adafruit/Adafruit-bq25185-with-5V-Boost-PCB/Adafruit bq25185 with 5V Boost Breakout.brd

## EAGLE design Adafruit bq25185 with 5V Boost Breakout.brd (2024-12-04)

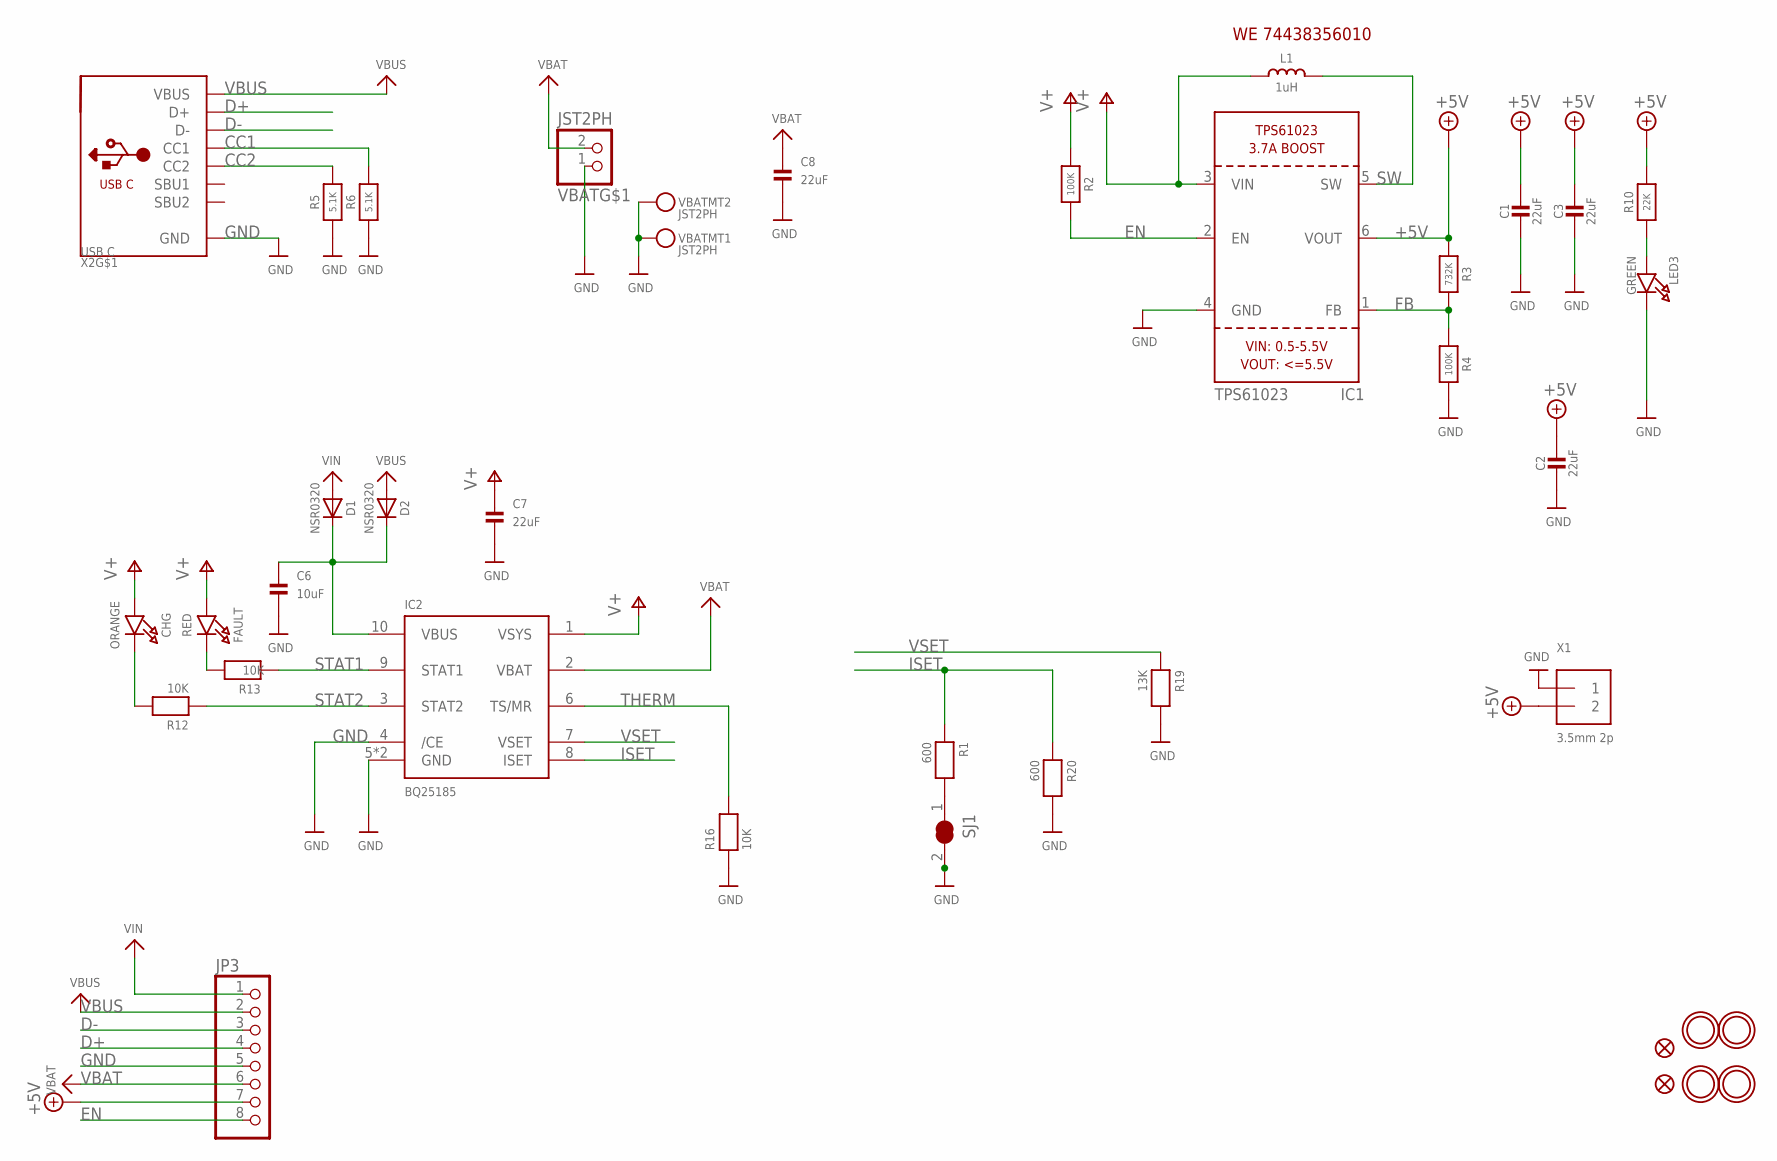
[picture p2: schematic Adafruit bq25185 with 5V Boost Breakout.sch, sheet 1]

Parts:
C1, C2, C3, C7, C8: 22uF; 0805-NO
C6: 10uF; 0805-NO
CHG: ORANGE; CHIPLED_0603_NOOUTLINE
D1, D2: NSR0320; SOD-323_MINI
FAULT: RED; CHIPLED_0603_NOOUTLINE
FID1, FID2: FIDUCIAL_0.5MM
IC1: TPS61023; SOT563
IC2: BQ25185; WSON10
JP3: HEADER-1X870MIL; 1X08_ROUND_70
L1: 1uH; INDUCTOR_5045_SMALLTABS
LED3: GREEN; CHIPLED_0603_NOOUTLINE
R1, R20: 600; _0402NO
R2, R4: 100K; _0402NO
R3: 732K; _0402NO
R5, R6: 5.1K; _0402NO
R10: 22K; _0402NO
R12, R13, R16: 10K; _0402NO
R19: 13K; _0402NO
SJ1: SOLDERJUMPER_CLOSED; SOLDERJUMPER_CLOSEDWIRE
U$9, U$10, U$11, U$12: MOUNTINGHOLE2.5; MOUNTINGHOLE_2.5_PLATED
VBAT: JST2PH; JSTPH2_BATT
X1: 3.5mm 2p; TERMBLOCK_1X2-3.5MM
X2: USB C; USB_C_CUSB31-CFM2AX-01-X

Connections:
+5V: C1.1, C2.1, C3.1, IC1.6 (VOUT), JP3.7, R3.1, R10.2, X1.2
CC1: R6.2, X2.A5 (CC1)
CC2: R5.2, X2.B5 (CC2)
D+: JP3.4, X2.A6 (D+), X2.B6 (D+)
D-: JP3.3, X2.A7 (D-), X2.B7 (D-)
EN: IC1.2 (EN), JP3.8, R2.2
FB: IC1.1 (FB), R3.2, R4.1
GND: C1.2, C2.2, C3.2, C6.2, C7.2, C8.2, IC1.4 (GND), IC2.4 (/CE), IC2.5 (GND), IC2.PAD (GND), JP3.5, LED3.C, R4.2, R5.1, R6.1, R16.1, R19.2, R20.2, SJ1.2, VBAT.1, VBAT.NC1, VBAT.NC2, X1.1, X2.A1B12 (GND), X2.B1A12 (GND)
ISET: IC2.8 (ISET), R1.1, R20.1
unnamed: R1.2, SJ1.1
unnamed: C6.1, D1.C, D2.C, IC2.10 (VBUS)
unnamed: CHG.C, R12.2
unnamed: LED3.A, R10.1
unnamed: FAULT.C, R13.2
STAT1: IC2.9 (STAT1), R13.1
STAT2: IC2.3 (STAT2), R12.1
SW: IC1.5 (SW), L1.2
THERM: IC2.6 (TS/MR), R16.2
V+: C7.1, CHG.A, FAULT.A, IC1.3 (VIN), IC2.1 (VSYS), L1.1, R2.1
VBAT: C8.1, IC2.2 (VBAT), JP3.6, VBAT.2
VBUS: D2.A, JP3.2, X2.A4B9 (VBUS), X2.B4A9 (VBUS)
VIN: D1.A, JP3.1
VSET: IC2.7 (VSET), R19.1

Notes on the sheet:
WE 74438356010

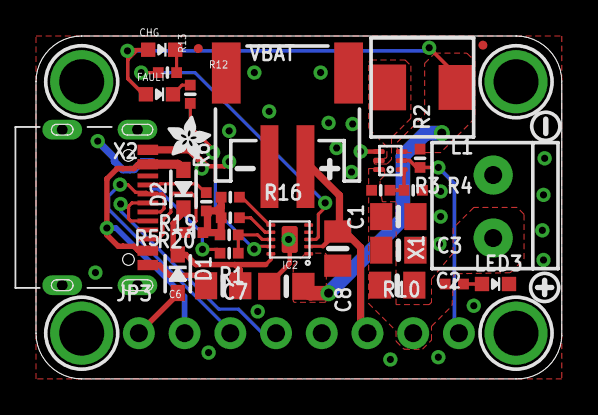
[picture p3: board Adafruit bq25185 with 5V Boost Breakout.brd from above]

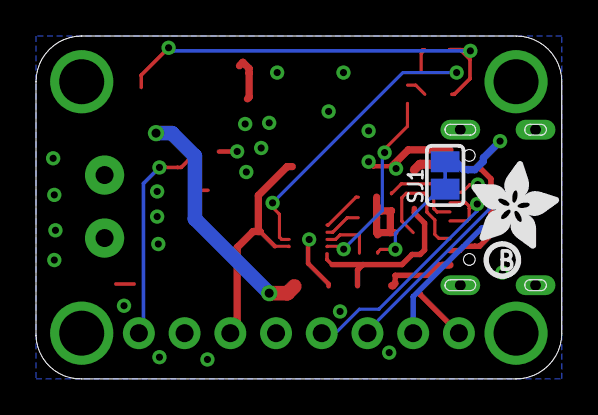
[picture p4: board Adafruit bq25185 with 5V Boost Breakout.brd from below]

Board: 2 copper layers, 29.2 x 19.1 mm, 66 parts (16 on the bottom side), 23 nets.

Other parts of the board:
PLABEL0: PLABEL0
PLABEL1: PLABEL1
PLABEL2: PLABEL2
PLABEL3: PLABEL3
PLABEL4: PLABEL4
PLABEL5: PLABEL5
PLABEL6: PLABEL6
PLABEL7: PLABEL7
PLABEL8: PLABEL8
PLABEL9: PLABEL9
PLABEL10: PLABEL10
PLABEL12: PLABEL12
PLABEL13: PLABEL13
PLABEL16: PLABEL16
PLABEL17: PLABEL17
PLABEL18: PLABEL18
PLABEL19: PLABEL19
PLABEL20: PLABEL20
PLABEL21: PLABEL21
PLABEL22: PLABEL22
PLABEL23: PLABEL23
PLABEL24: PLABEL24
PLABEL25: PLABEL25
PLABEL26: PLABEL26
U$2: PCBFEAT-REV-040
U$3: SYMBOL_PLUS
U$4: SYMBOL_MINUS
U$26: ADAFRUIT_5MM
U$34: ADAFRUIT_2.5MM
